mjs2011/Oil-Burner/diagram.png

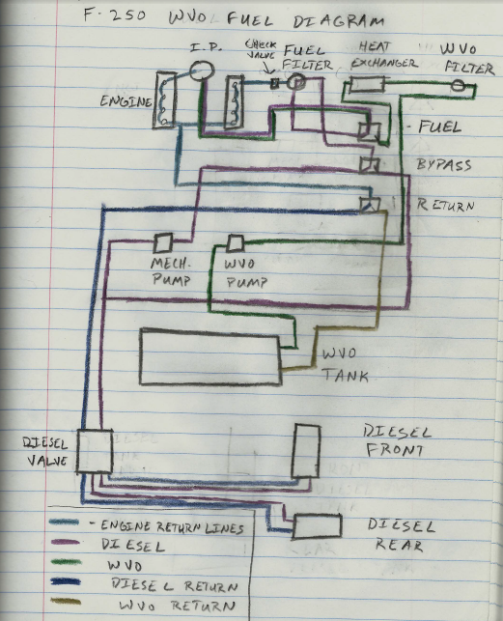
diagram.png
