mjs2011/Oil-Burner/wiring schematic.pdf

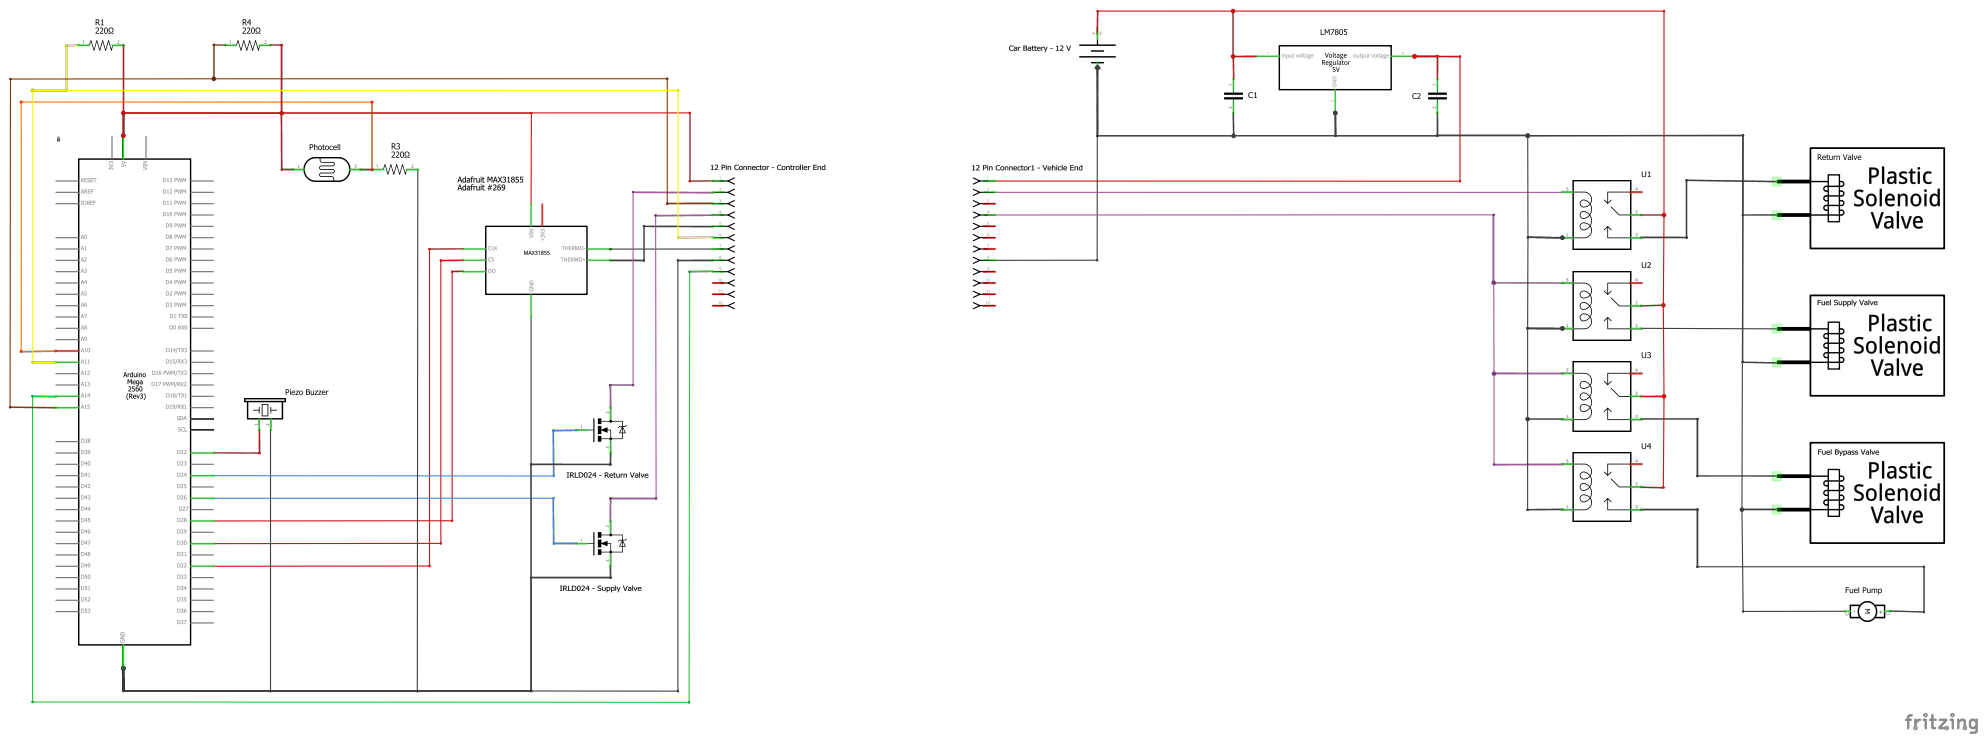
[picture p4: page 1]
