mjs2011/Oil-Burner/(commit log)

2017-08-22 Code in Folder
    The Arduino IDE requires code to be in a folder with the same name
2017-08-22 Temperature Polynomial Function
    The code calculating the temperature from the temp sender was put in a function and removed from the loop to clean up the loop
2017-08-22 Omitted Code for Valve Status Indicators
    Initially, I planned to use reed switches to determine of the solenoid valves were powered. THis didnt work very well, so I commented out the code that displayed this info. It has now been removed from the code entirely
2017-08-22 edit comment for oil temp polynomial
    [Oil Temp gage values.xlsx]
2017-08-22 Wiring Schematic
    Schematic of Oil Controller Circuitry and Truck circuitry for the WVO System
2017-08-22 Auto Brightness Calculation
    Spreadsheet to calculate the relationship between needed screen brightness and reading from photodiode
    [AutoBrightness Equations.xlsx]
2017-08-22 Pressure Sender voltage curve
    correlation between pressure and voltage
    [pressure sender curve.xlsx]
2017-08-22 Fuel Sender Voltage Divider Curve
    [Fuel Sender Voltage Divider.xlsx]
